obono/ESP8266SmartRemocon/(commit log)

2024-04-20 :sparkles: Support atmospheric pressure
2026-03-09 :bug: Correct the order of arguments in case of using static IP address
    [ESP8266SmartRemocon.ino]
